jehelmich/Etch_a_Sketch/hardware/quartus/clarvi_fpga.sv

//
// Copyright (c) 2015 A. Theodore Markettos
// All rights reserved.
//
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
// Top level file for DE1-SoC board with
// Cambridge display board

// Uncomment this if you have an HPS (ARM CPU) in your design
//`define ENABLE_HPS

module clarvi_fpga(

      // Analogue-digital converter
      inout              ADC_CS_N,
      output             ADC_DIN,
      input              ADC_DOUT,
      output             ADC_SCLK,

      // Audio DAC
      input              AUD_ADCDAT,
      inout              AUD_ADCLRCK,
      inout              AUD_BCLK,
      output             AUD_DACDAT,
      inout              AUD_DACLRCK,
      output             AUD_XCK,

      // Clocks
      input              CLOCK_50,
      input              CLOCK2_50,
      input              CLOCK3_50,
      input              CLOCK4_50,

      // FPGA-side SDRAM
      output      [12:0] DRAM_ADDR,
      output      [1:0]  DRAM_BA,
      output             DRAM_CAS_N,
      output             DRAM_CKE,
      output             DRAM_CLK,
      output             DRAM_CS_N,
      inout       [15:0] DRAM_DQ,
      output             DRAM_LDQM,
      output             DRAM_RAS_N,
      output             DRAM_UDQM,
      output             DRAM_WE_N,

      // Fan control (unused on native board)
      output             FAN_CTRL,

      // FPGA I2C
      output             FPGA_I2C_SCLK,
      inout              FPGA_I2C_SDAT,

      // General purpose I/O
      inout     [35:0]         GPIO_0,
 
      // Hex LEDs
      output      [6:0]  HEX0,
      output      [6:0]  HEX1,
      output      [6:0]  HEX2,
      output      [6:0]  HEX3,
      output      [6:0]  HEX4,
      output      [6:0]  HEX5,

`ifdef ENABLE_HPS
      // ARM Cortex A9 Hard Processor System
      inout              HPS_CONV_USB_N,
      output      [14:0] HPS_DDR3_ADDR,
      output      [2:0]  HPS_DDR3_BA,
      output             HPS_DDR3_CAS_N,
      output             HPS_DDR3_CKE,
      output             HPS_DDR3_CK_N,
      output             HPS_DDR3_CK_P,
      output             HPS_DDR3_CS_N,
      output      [3:0]  HPS_DDR3_DM,
      inout       [31:0] HPS_DDR3_DQ,
      inout       [3:0]  HPS_DDR3_DQS_N,
      inout       [3:0]  HPS_DDR3_DQS_P,
      output             HPS_DDR3_ODT,
      output             HPS_DDR3_RAS_N,
      output             HPS_DDR3_RESET_N,
      input              HPS_DDR3_RZQ,
      output             HPS_DDR3_WE_N,
      output             HPS_ENET_GTX_CLK,
      inout              HPS_ENET_INT_N,
      output             HPS_ENET_MDC,
      inout              HPS_ENET_MDIO,
      input              HPS_ENET_RX_CLK,
      input       [3:0]  HPS_ENET_RX_DATA,
      input              HPS_ENET_RX_DV,
      output      [3:0]  HPS_ENET_TX_DATA,
      output             HPS_ENET_TX_EN,
      inout       [3:0]  HPS_FLASH_DATA,
      output             HPS_FLASH_DCLK,
      output             HPS_FLASH_NCSO,
      inout              HPS_GSENSOR_INT,
      inout              HPS_I2C1_SCLK,
      inout              HPS_I2C1_SDAT,
      inout              HPS_I2C2_SCLK,
      inout              HPS_I2C2_SDAT,
      inout              HPS_I2C_CONTROL,
      inout              HPS_KEY,
      inout              HPS_LED,
      inout              HPS_LTC_GPIO,
      output             HPS_SD_CLK,
      inout              HPS_SD_CMD,
      inout       [3:0]  HPS_SD_DATA,
      output             HPS_SPIM_CLK,
      input              HPS_SPIM_MISO,
      output             HPS_SPIM_MOSI,
      inout              HPS_SPIM_SS,
      input              HPS_UART_RX,
      output             HPS_UART_TX,
      input              HPS_USB_CLKOUT,
      inout       [7:0]  HPS_USB_DATA,
      input              HPS_USB_DIR,
      input              HPS_USB_NXT,
      output             HPS_USB_STP,
`endif /*ENABLE_HPS*/

      // Infra-red
      input              IRDA_RXD,
      output             IRDA_TXD,

      // Push buttons on DE1-SoC mainboard
      input       [3:0]  KEY,

      // Red LED row
      output      [9:0]  LEDR,

      // PS2 port
      inout              PS2_CLK,
      inout              PS2_CLK2,
      inout              PS2_DAT,
      inout              PS2_DAT2,

      // Slide switches
      input       [9:0]  SW,

      // TMDS
      input              TD_CLK27,
      input      [7:0]  TD_DATA,
      input             TD_HS,
      output             TD_RESET_N,
      input             TD_VS,


      // VGA video
      output      [7:0]  VGA_B,
      output             VGA_BLANK_N,
      output             VGA_CLK,
      output      [7:0]  VGA_G,
      output             VGA_HS,
      output      [7:0]  VGA_R,
      output             VGA_SYNC_N,
      output             VGA_VS,

      // Cambridge display board (plugged into GPIO1 port)

      // rotary dials
      input       [1:0]  DIALL,
      input       [1:0]  DIALR,
      // LED pixel ring (inverted before reaching ring)
      output             LEDRINGn,
      
      // LCD display
      output      [7:0]  LCD_R,
      output      [7:0]  LCD_G,
      output      [7:0]  LCD_B,
      // -- only LCD_R[7:2], LCD_G[7:1], LCD_B[7:2] are wired
      // through to display board, low-order pins are ignored
        
      output             LCD_HSYNC,
      output             LCD_VSYNC,
      output             LCD_DEN,
      output             LCD_DCLK,
      output             LCD_ON,	    // set high to enable LCD panel
      output             LCD_BACKLIGHT, // set high to turn on backlight, PWM to dim
      
      // shift register for buttons on display board
      output             SHIFT_CLKIN,
      output             SHIFT_LOAD,
      input              SHIFT_OUT,

      // capacitive touch sensor reset (high=enabled)
      output             TOUCH_WAKE,
      // I2C for touch, temperature and EEPROM
      inout              DISPLAY_SDA,
      inout              DISPLAY_SCL

);

	// The LCD panel and its backlight are simply held on.
	assign LCD_BACKLIGHT = 1'b1;
	assign LCD_ON        = 1'b1;

	// Three hex digits driven by the SoC's hex PIO, one byte per pair of digits.
	logic [23:0] hexSignal;

	clarvi_soc qsys0 (
        .clk_clk                                  (CLOCK_50),// clk.clk
        .hex_pio_external_connection_export       (hexSignal),// hex_pio_external_connection.export
        .led_pio_external_connection_export        (LEDRINGn),// led_pio_external_connection.export
        .pixelstream_0_conduit_end_0_lcd_red   (LCD_R),   // pixelstream_0_conduit_end_0.lcd_red
        .pixelstream_0_conduit_end_0_lcd_green (LCD_G), //                            .lcd_green
        .pixelstream_0_conduit_end_0_lcd_blue  (LCD_B),  //                            .lcd_blue
        .pixelstream_0_conduit_end_0_lcd_hsync (LCD_HSYNC), //                            .lcd_hsync
        .pixelstream_0_conduit_end_0_lcd_vsync (LCD_VSYNC), //                            .lcd_vsync
        .pixelstream_0_conduit_end_0_lcd_de    (LCD_DEN),    //                            .lcd_de
        .pixelstream_0_conduit_end_0_lcd_dclk    (LCD_DCLK),    //                            .lcd_dclk
        //.pixelstream_0_conduit_end_0_lcd_dclk_en (<connected-to-pixelstream_0_conduit_end_0_lcd_dclk_en>),      
		  .reset_reset_n                            (KEY[0]), //             reset.reset_n
        //.rotaryctl2_0_rotary_event_rotary_ccw      (<connected-to-rotaryctl2_0_rotary_event_rotary_ccw>),
        //.rotaryctl2_0_rotary_event_rotary_cw       (<connected-to-rotaryctl2_0_rotary_event_rotary_cw>), 
        //.rotaryctl2_1_rotary_event_rotary_ccw      (<connected-to-rotaryctl2_1_rotary_event_rotary_ccw>), 
        //.rotaryctl2_1_rotary_event_rotary_cw       (<connected-to-rotaryctl2_1_rotary_event_rotary_cw>),  
        .rotaryctl2_1_rotary_in_rotary_in          (DIALR),          //      rotaryctl2_1_rotary_in.rotary_in
        .rotaryctl2_0_rotary_in_rotary_in          (DIALL),          //      rotaryctl2_0_rotary_in.rotary_in
        .shiftregctl_0_shiftreg_ext_shiftreg_clk   (SHIFT_CLKIN),   //  shiftregctl_0_shiftreg_ext.shiftreg_clk
        .shiftregctl_0_shiftreg_ext_shiftreg_loadn (SHIFT_LOAD), //                            .shiftreg_loadn
        .shiftregctl_0_shiftreg_ext_shiftreg_out   (SHIFT_OUT)    //                            .shiftreg_out
    );


	hex_led u0 (
        .clk_clk                              (CLOCK_50),//     clk.clk
        .eightbitstosevenseg_0_led_pins_led0  (HEX0),  // eightbitstosevenseg_0_led_pins.led0
        .eightbitstosevenseg_0_led_pins_led1  (HEX1),  //                               .led1
        .reset_reset_n                        (KEY[0]),//                          reset.reset_n
        .eightbitstosevenseg_0_data_in_export (hexSignal[7:0]),//  eightbitstosevenseg_0_data_in.export
        .eightbitstosevenseg_1_led_pins_led0  (HEX2),  // eightbitstosevenseg_1_led_pins.led0
        .eightbitstosevenseg_1_led_pins_led1  (HEX3),  //                               .led1
        .eightbitstosevenseg_1_data_in_export (hexSignal[15:8]), //  eightbitstosevenseg_1_data_in.export
        .eightbitstosevenseg_2_data_in_export (hexSignal[23:16]), //  eightbitstosevenseg_2_data_in.export
        .eightbitstosevenseg_2_led_pins_led0  (HEX4),  // eightbitstosevenseg_2_led_pins.led0
        .eightbitstosevenseg_2_led_pins_led1  (HEX5)   //                               .led1
    );

endmodule

  
