jehelmich/Etch_a_Sketch/(commit log)

2026-09-14 build: fetch the Clarvi core as a pinned submodule
    `clarvi.sv` and `clarvi_avalon.sv` were byte-identical to upstream, and
    `riscv.svh` differed only in trailing whitespace, so there was nothing local to
    preserve. Replace the copies with a submodule pinned to ucam-comparch/clarvi
    at 2b4cb95.
    Clarvi is a 6-stage in-order RV32I core written at the Cambridge Computer
    Laboratory for teaching, BSD 2-Clause, (c) 2016 Robert Eady.
    The component description stays in this repository rather than being used from
    the submodule, with its source paths pointing into third_party/. Upstream ships
    its own clarvi_hw.tcl, and having both on the Qsys search path would define the
    component twice; IP_SEARCH_PATHS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
2026-09-14 fix: wire the hex displays to a clock that exists
    The top level connected the hex_led system's clock to `CLK_50`. The DE1-SoC's
    clock port is `CLOCK_50`; `CLK_50` was declared nowhere. SystemVerilog turns an
    undeclared identifier in a port connection into an implicit wire rather than
    raising an error, so this synthesised cleanly while leaving the six
    seven-segment displays clocked by nothing.
    Untested on hardware - I no longer have the board - but the intent is not in
    doubt.
    Also in this commit, two things that stop the software building today:
    - txt2hex.py was Python 2 only: `/` on the byte count and the address made
    floats under Python 3, which then formatted as `%04X` and raised.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
    [clarvi_fpga.sv]
2026-09-14 refactor(software): split the display primitives out of the sketch
    etch_a_sketch.c held the framebuffer code, the pixel format macros and the
    sketch loop together, and the two headers were named after the file that
    included them rather than the file that implemented them. Behaviour is
    unchanged.
    display.{c,h} vid_set_pixel, clear_screen, the 16-bit pixel format
    peripherals.{c,h} avalon_read / avalon_write (was etch_a_sketch_header.h)
    etch_a_sketch.{c,h} the sketch loop (was main_header.h)
    Also:
    - `#import` becomes `#include`. It is a Clang extension that GCC does not
    accept for C, so as written this only ever built by accident of the
    toolchain.
    - The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
2026-09-14 docs: add README, architecture and build notes, licence and attribution
    The README was two sentences and there was nothing else. Replace it with an
    explanation of what the design actually does, and add:
    docs/architecture.md the SoC, the memory map, each custom peripheral, and
    how the sketch loop works
    docs/building.md toolchain and board prerequisites, the one-off Qsys
    generation step, known issues, and what changed when
    the repository was cleaned up
    software/readme.md described how to use the Makefile; that is now part of
    docs/building.md.
    LICENSE puts my own work under BSD 2-Clause, matching the licence al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
2026-09-14 fix: declare the seven-segment outputs as variables
    digit0 and digit1 are driven from an always_comb block but were declared
    without a type, which makes them nets. A procedural block may not drive a net;
    Quartus accepts it, stricter tools do not.
    Same class of error as the LCD_ON / LCD_BACKLIGHT block in the top level.
    [EightBitsToSevenSeg.sv]
2026-09-14 build: fix the link step and let the architecture string be overridden
    Two things stopped the firmware building on a current toolchain.
    The link rule invoked gcc without TARGET_ARCH, so the driver linked for its
    own default architecture and rejected every 32-bit object:
    ABI is incompatible with that of the selected emulation:
    target emulation `elf32-littleriscv' does not match `elf64-littleriscv'
    This only ever worked because the 2017 lab toolchain could not target
    anything but rv32.
    Second, init.s uses csrw to install a trap handler. GCC 11 moved the CSR
    instructions into the zicsr extension, so -march=rv32i no longer assembles
    them. The default is now rv32i_zicsr, overridable w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
2026-09-14 test: run the firmware on a simulated SoC and check what it draws
    sim/rtl/soc_sim.sv stands in for the Qsys interconnect, which is a build
    artifact and so is not in this repository. It decodes the same memory map that
    software/src/avalon_addr.h describes and attaches the same peripherals. The
    Clarvi core, both rotary decoders and the button scanner are the real RTL.
    The harness knows nothing about the program. It turns the dials, presses a
    button and reads the framebuffer back -- the same inputs and outputs the board
    has -- then checks that:
    - the core fetches instructions after reset
    - exactly one pixel is lit before anything is touched
    - tracing an 80x50 rectangle lights 260 pixels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
    [soc_sim.sv]
2026-09-14 ci: lint, test and simulate on every push
    Two jobs, so that a problem with the cross-compiler does not hide the state of
    the RTL:
    rtl installs Verilator, lints the hand-written peripherals and runs their
    unit tests. No submodule, no toolchain.
    soc additionally installs gcc-riscv64-unknown-elf, builds the firmware, runs
    it on the simulated SoC and uploads the picture it drew.
    Waveform dumps use VCD rather than FST. FST needs lz4 headers that are not on
    the include path in every Verilator install -- it fails on a stock Homebrew
    one -- and a debugging aid is not worth a build dependency that breaks on
    someone else's machine. Only a window of cycles is traced, since a full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
2026-09-14 docs: explain how to run the design without the board, and how to extend it
    simulation.md covers what is real RTL and what is a model, the two bus
    contracts the core imposes that are easy to get wrong, why the debounce window
    is a parameter, and how to get a waveform out.
    extending.md walks a peripheral through every layer it has to touch: the RTL,
    a unit test, the Qsys component description, the system itself, the memory map
    shared with the firmware, the simulation model, and the C that finally uses it.
    The example is a microsecond timer; its RTL lints clean as written.
    The README now opens with the picture the simulation draws and the four
    commands that reproduce it, rather than a descri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
2026-09-14 feat: an interactive front end, natively and in the browser
    sim/app/etch.cpp puts a window on the simulation. Arrow keys synthesise
    quadrature on the same pins the encoders drive on the board, the simulated core
    polls them and plots pixels, and the framebuffer is blitted to the screen each
    frame. Everything between the keypress and the pixel is the design's own RTL.
    make -C sim run native, needs SDL2
    make -C sim web WebAssembly, needs Emscripten
    make -C sim serve build it and serve it locally
    Measured on an M3 Pro: 10.8 MHz simulated natively, 7.0 MHz through
    WebAssembly, against the board's 50 MHz. Nothing here is latency-critical
    relative to a human hand -- a dia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
2026-09-14 ci: deploy the browser build to Pages, and check the front end on every push
    pages.yml builds the WebAssembly front end and publishes it to GitHub Pages on
    each push to main. Pages has to be switched to "GitHub Actions" as its source in
    the repository settings once, or the deploy step has nothing to publish to.
    The SoC job also runs the front end headlessly now, which exercises the input
    path -- keyboard to quadrature to decoder to firmware -- that `make soc` drives
    directly rather than through the same code a person uses.
    The README opens with the link to the running thing, and simulation.md picks up
    the two Emscripten workarounds so they are written down somewhere other than a
    commit mes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
2026-09-14 ci: build Verilator from source for the Pages job
    Ubuntu ships Verilator 5.020, whose verilatedos.h has no VL_CPU_RELAX case for
    wasm32 and stops with "Missing VL_CPU_RELAX() definition." Support for the
    target came later, so the browser build needs a newer release; it is pinned and
    cached, and the first build is the only slow one.
    The native jobs in ci.yml keep using the packaged Verilator, which is fine for
    them.
2026-09-14 fix: pace the front end against the display
    The native build had no frame limiter and no vsync, so the loop free-ran: it
    simulated a hardcoded 12 ms of cycles, presented immediately and went round
    again. The frame rate was whatever the machine happened to manage and drifted
    with load.
    Frames are now paced by vsync, falling back to a deadline-scheduled limiter if
    the renderer refuses it. On a 50 Hz display that gives a flat 50 fps and a
    steady 8.7 MHz, where before both wandered.
    The same hardcoded 12 ms was a bug in the browser build for the opposite
    reason. requestAnimationFrame was already pacing it, but 12 ms of simulation
    does not fit in the 8.3 ms frame of a 120 Hz display, so it coul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
    [etch.cpp]
2026-09-14 feat: touch controls, so the page works on a phone
    The deployed page needed a keyboard, which makes it useless on the device most
    people will open a link on. It now has two drag pads and a clear button.
    They do not synthesise key events. The page calls an exported function,
    etch_input(left, right, clear), and the simulation merges that with the
    keyboard, keys winning where both are in play. Faking a keyboard would not have
    worked anyway: a touch device cannot give the canvas keyboard focus, which is
    also why the page no longer has to be clicked before it responds.
    Dragging is proportional -- distance from where the finger landed sets the
    speed, with a dead zone so a resting thumb does not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
    [etch.cpp]
